IdorBogdanIoan/sonicgrid_v2/Inc/main.h

#define VBUS_SENSE_Pin GPIO_PIN_2
#define VBUS_SENSE_GPIO_Port GPIOC
#define UCPD_FLT_Pin GPIO_PIN_14
#define UCPD_FLT_GPIO_Port GPIOB
#define UCPD_DBn_Pin GPIO_PIN_5
#define UCPD_DBn_GPIO_Port GPIOB
