IdorBogdanIoan/sonicgrid_v2/Inc/mel_table.h

// GENERAT AUTOMAT de tools/gen_mel_table.py - nu edita manual.
// Trebuie regenerat daca schimbi DeviceSpec, si modelul reantrenat.
#pragma once
#include <stdint.h>

#define SG_SAMPLE_RATE   16000
#define SG_FRAME_LEN     512
#define SG_HOP_LEN       320
#define SG_N_FFT         512
#define SG_N_BINS        257
#define SG_N_MELS        40
#define SG_HP_HZ         120.0f
#define SG_LOG_EPS       1e-06f
#define SG_LOG_MIN       -6.0f
#define SG_LOG_MAX       2.0f
#define SG_MEL_NNZ       357

static const float sg_window[SG_FRAME_LEN] = {
  0.0f,3.7640333e-05f,0.00015059114f,0.0003388226f,0.00060227513f,0.00094094872f,0.0013547838f,0.0018436909f,0.0024076402f,0.0030465126f,0.0037602484f,0.0045486987f,0.0054117441f,0.0063492954f,0.0073611736f,0.0084472597f,0.0096073449f,0.01084131f,0.012148947f,0.013530016f,0.014984369f,0.016511768f,0.018111974f,0.019784749f,0.021529824f,0.02334699f,0.025235921f,0.027196348f,0.029227972f,0.031330496f,0.033503592f,0.035746962f,0.038060248f,0.040443063f,0.042895138f,0.045416027f,0.048005342f,0.050662756f,0.053387851f,0.056180209f,0.059039384f,0.061964959f,0.064956516f,0.068013579f,0.0711357f,0.074322402f,0.07757321f,0.080887645f,0.084265202f,0.087705374f,0.091207594f,0.094771415f,0.098396242f,0.10208154f,0.1058268f,0.10963139f,0.11349478f,0.11741638f,0.12139559f,0.12543181f,0.12952444f,0.13367289f,0.13787645f,0.14213461f,0.14644662f,0.15081188f,0.15522975f,0.1596995f,0.16422054f,0.16879213f,0.1734136f,0.17808422f,0.18280336f,0.18757027f,0.19238421f,0.1972445f,0.20215034f,0.20710108f,0.21209592f,0.21713409f,0.22221491f,0.22733751f,0.23250118f,0.23770517f,0.24294865f,0.24823079f,0.25355089f,0.25890815f,0.26430166f,0.26973063f,0.27519435f,0.28069192f,0.28622246f,0.29178524f,0.29737937f,0.30300403f,0.3086583f,0.31434143f,0.3200525f,0.32579064f,0.33155507f,0.33734488f,0.34315917f,0.34899703f,0.35485768f,0.36074018f,0.36664361f,0.37256718f,0.37850994f,0.38447094f,0.3904494f,0.39644432f,0.40245488f,0.40848005f,0.41451907f,0.42057097f,0.42663476f,0.43270966f,0.43879467f,0.44488895f,0.450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
6073449f,0.0084472299f,0.0073611736f,0.0063492656f,0.0054117143f,0.0045486689f,0.0037602186f,0.0030465126f,0.0024076104f,0.0018436909f,0.0013547838f,0.00094094872f,0.00060227513f,0.0003388226f,0.00015059114f,3.7640333e-05f
};

static const float sg_mel_w[SG_MEL_NNZ] = {
  0.0048953625f,0.0130543f,0.011103074f,0.00294414f,0.0050550792f,0.01321401f,0.010943357f,0.0027844263f,0.0052147936f,0.013373727f,0.010783645f,0.002624708f,0.0053745098f,0.01353345f,0.010623926f,0.0024649876f,0.0055342275f,0.013693162f,0.010464205f,0.0023052793f,0.0056939428f,0.01385287f,0.010304496f,0.0021455609f,0.0058536567f,0.014012596f,0.010144781f,0.0019858412f,0.0060133776f,0.014172317f,0.0099850604f,0.0018261204f,0.006173098f,0.014332037f,0.0098253386f,0.0016663995f,0.0063328152f,0.01449175f,0.0096656187f,0.0015066925f,0.0064925267f,0.014651449f,0.0095059108f,0.0013469872f,0.0066440082f,0.014792846f,0.0093514519f,0.0012227367f,0.0065577878f,0.014412308f,0.0093413312f,0.0019818323f,0.0058622751f,0.012762494f,0.0098903188f,0.0034167198f,0.0044378582f,0.010511202f,0.011026116f,0.0053282906f,0.0025241941f,0.0078697177f,0.012543305f,0.0075283023f,0.0025132999f,0.0003051403f,0.0050100684f,0.0097149964f,0.0098709874f,0.0054569528f,0.001042919f,0.0020657699f,0.0062068864f,0.010348002f,0.0083593102f,0.004474245f,0.00058917934f,0.0027836689f,0.0064285193f,0.010073369f,0.0077252029f,0.0043057124f,0.00088622235f,0.0027215518f,0.0059296135f,0.0091376752f,0.0077394177f,0.0047297138f,0.0017200103f,0.0020918236f,0.0049154377f,0.0077390517f,0.0082175722f,0.0055685383f,0.0029195042f,0.00027047048f,0.0010649577f,0.0035502051f,0.0060354527f,0.008520701f,0.0066809193f,0.0043493314f,0.0020177434f,0.0019640864f,0.0041515124f,0.0063389381f,0.0079556908f,0.0059035155f,0.0038513402f,0.001799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
static const uint16_t sg_mel_len[SG_N_MELS] = {4,4,4,4,4,4,4,4,4,4,4,4,4,4,4,5,6,6,6,6,7,7,7,9,9,9,10,11,12,12,13,14,14,15,17,18,19,20,22,23};
