IdorBogdanIoan/sonicgrid_v2/Inc/sg_pcen_params.h

/* Parametrii PCEN, pe banda.

   GENERAT din runs/v2/best.pt de tools/gen_pcen_params.py.
   Inlocuiesc valorile neantrenate (alpha 0.98, delta 2.0, r 0.5 peste tot).
   Daca reantrenezi, regenereaza fisierul asta, altfel placa normalizeaza
   cu alti coeficienti decat cei pe care i-a invatat modelul. */
#pragma once

#include "mel_table.h"

#define SG_PCEN_S        0.048770577f
#define SG_PCEN_EPS      1e-6f

static const float sg_pcen_alpha[SG_N_MELS] = {
  0.97991782f,0.98002863f,0.98006767f,0.98000491f,0.97991735f,0.98000473f,0.97992581f,0.97991562f,0.9798165f,0.97995687f,0.97990108f,0.97990078f,0.97990638f,0.97988379f,0.97995949f,0.97992581f,0.97993451f,0.97988963f,0.97995007f,0.97999316f,0.97991818f,0.9799574f,0.98002899f,0.97997642f,0.98000014f,0.98000389f,0.98000515f,0.9799422f,0.98001766f,0.98001808f,0.97999144f,0.98000205f,0.98001671f,0.97997952f,0.97995752f,0.98007548f,0.97994906f,0.97998124f,0.98000526f,0.9799937f
};

static const float sg_pcen_delta[SG_N_MELS] = {
  2.0008492f,1.9994191f,1.9980114f,1.9992844f,2.0029604f,1.9980277f,2.0025923f,2.002214f,1.9998975f,1.9973445f,2.0007958f,1.9993805f,1.9986863f,1.9998527f,2.0015707f,1.9998525f,1.9981662f,1.9996257f,2.0007889f,1.9995193f,2.0019102f,2.0006974f,1.9974508f,1.9995288f,2.0009646f,2.000571f,1.9995201f,2.0034311f,1.9978923f,1.9990164f,2.0007386f,2.0002329f,1.9990218f,2.0012066f,2.000946f,1.9971275f,2.002172f,1.9994599f,2.0007944f,1.9999347f
};

static const float sg_pcen_r[SG_N_MELS] = {
  0.49966761f,0.50007993f,0.50029677f,0.50017977f,0.49912938f,0.50051695f,0.49904588f,0.49934831f,0.49971181f,0.500763f,0.49963304f,0.50018013f,0.50047952f,0.50038725f,0.49980813f,0.50016701f,0.5002178f,0.49996984f,0.49987152f,0.50022155f,0.49944818f,0.49994063f,0.50066185f,0.50018239f,0.49977961f,0.50013763f,0.50021142f,0.49913931f,0.5005818f,0.50003302f,0.49991098f,0.50002229f,0.50036871f,0.49971187f,0.49957752f,0.50081635f,0.49956706f,0.49980626f,0.50010002f,0.50028259f
};
